GQuinteroP/MASN/docs/img/SENSOR_FRONT.pdf

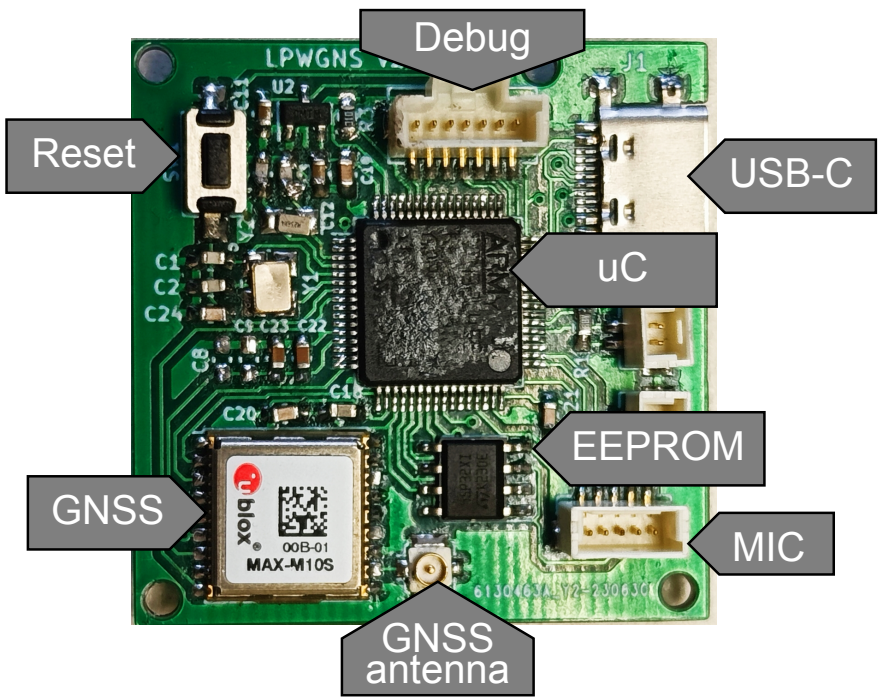
[picture p1: figure]
Debug; EEPROM; USB-C; GNSS; Reset; MIC; GNSS antenna
