GQuinteroP/MASN/docs/img/PCB_FRONT.pdf

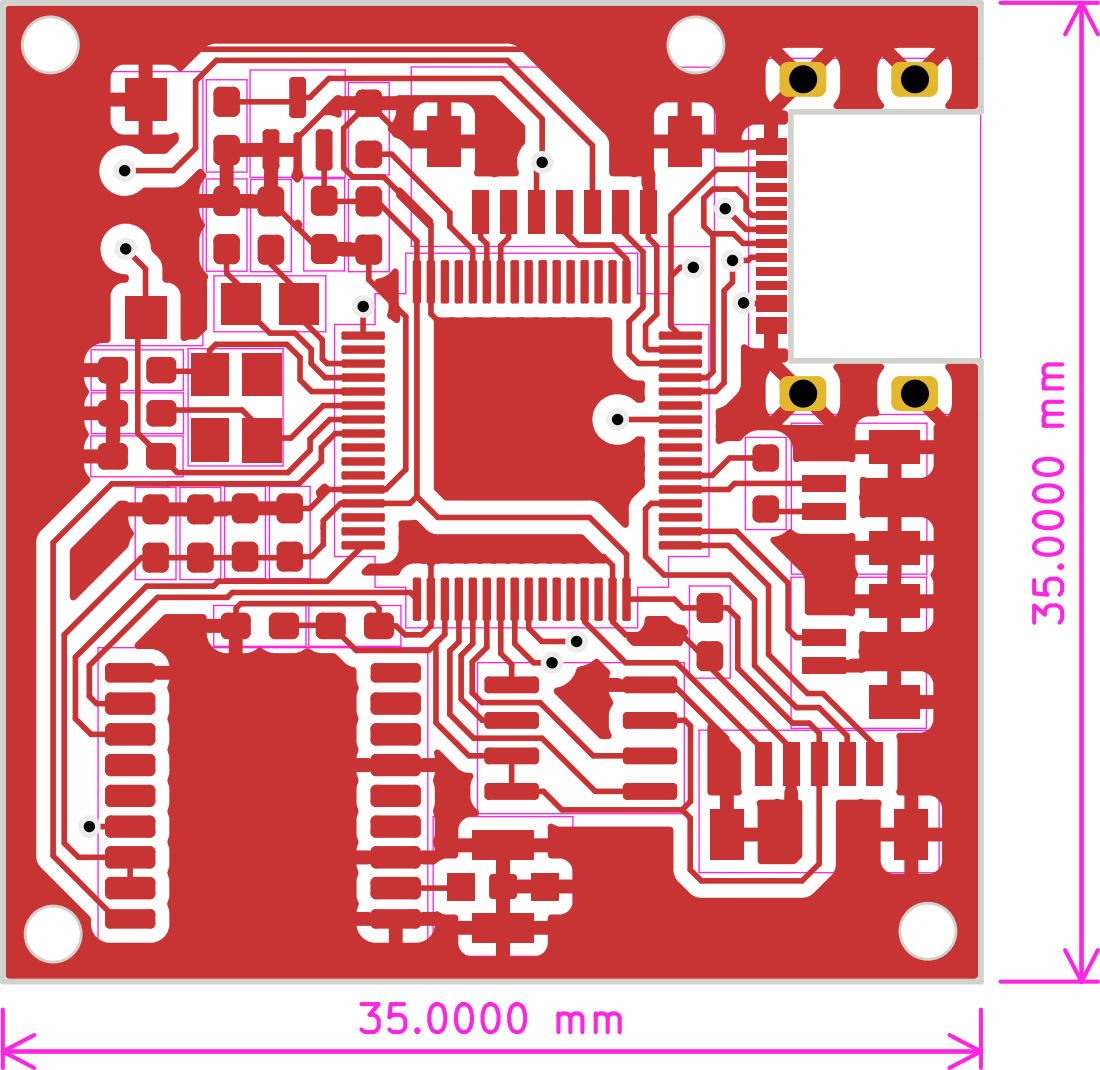
[picture p2: page 1]
