GQuinteroP/MASN/docs/img/PCB_REAR.pdf

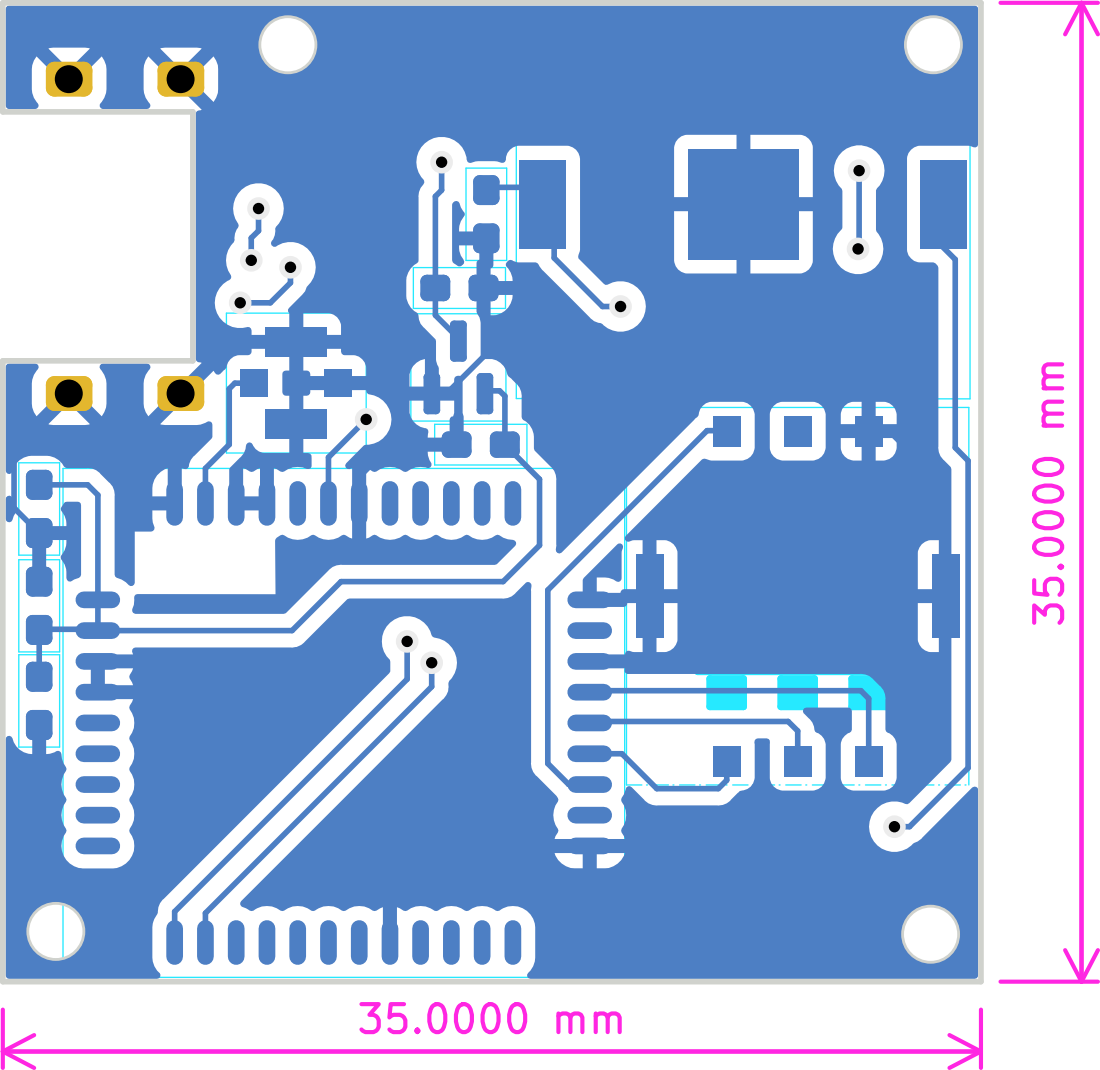
[picture p3: page 1]
