GQuinteroP/MASN/docs/img/SENSOR_BACK.pdf

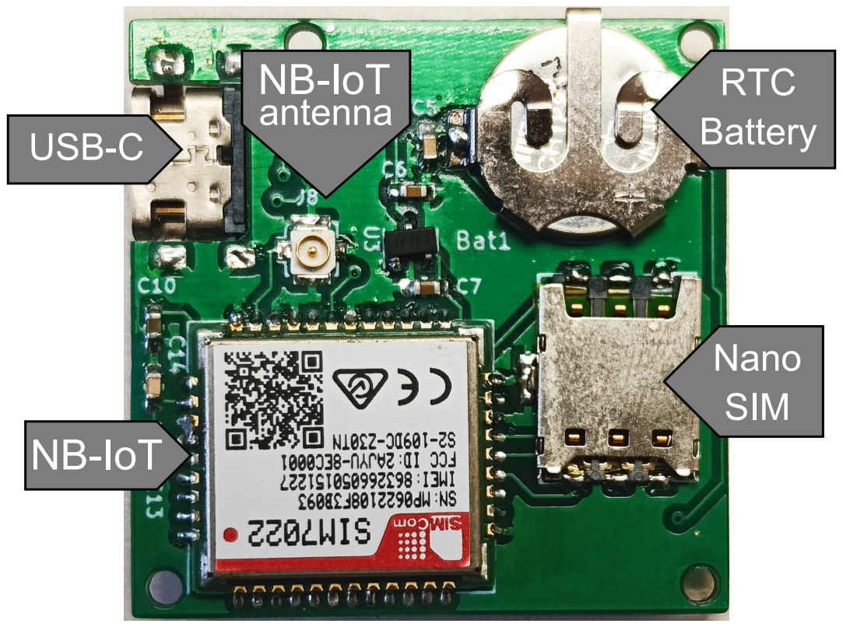
[picture p4: page 1]
NB-IoT
