GQuinteroP/MASN/PCB/MASN.kicad_pcb

## KiCad design PCB/MASN.kicad_pcb (2026-05-15)

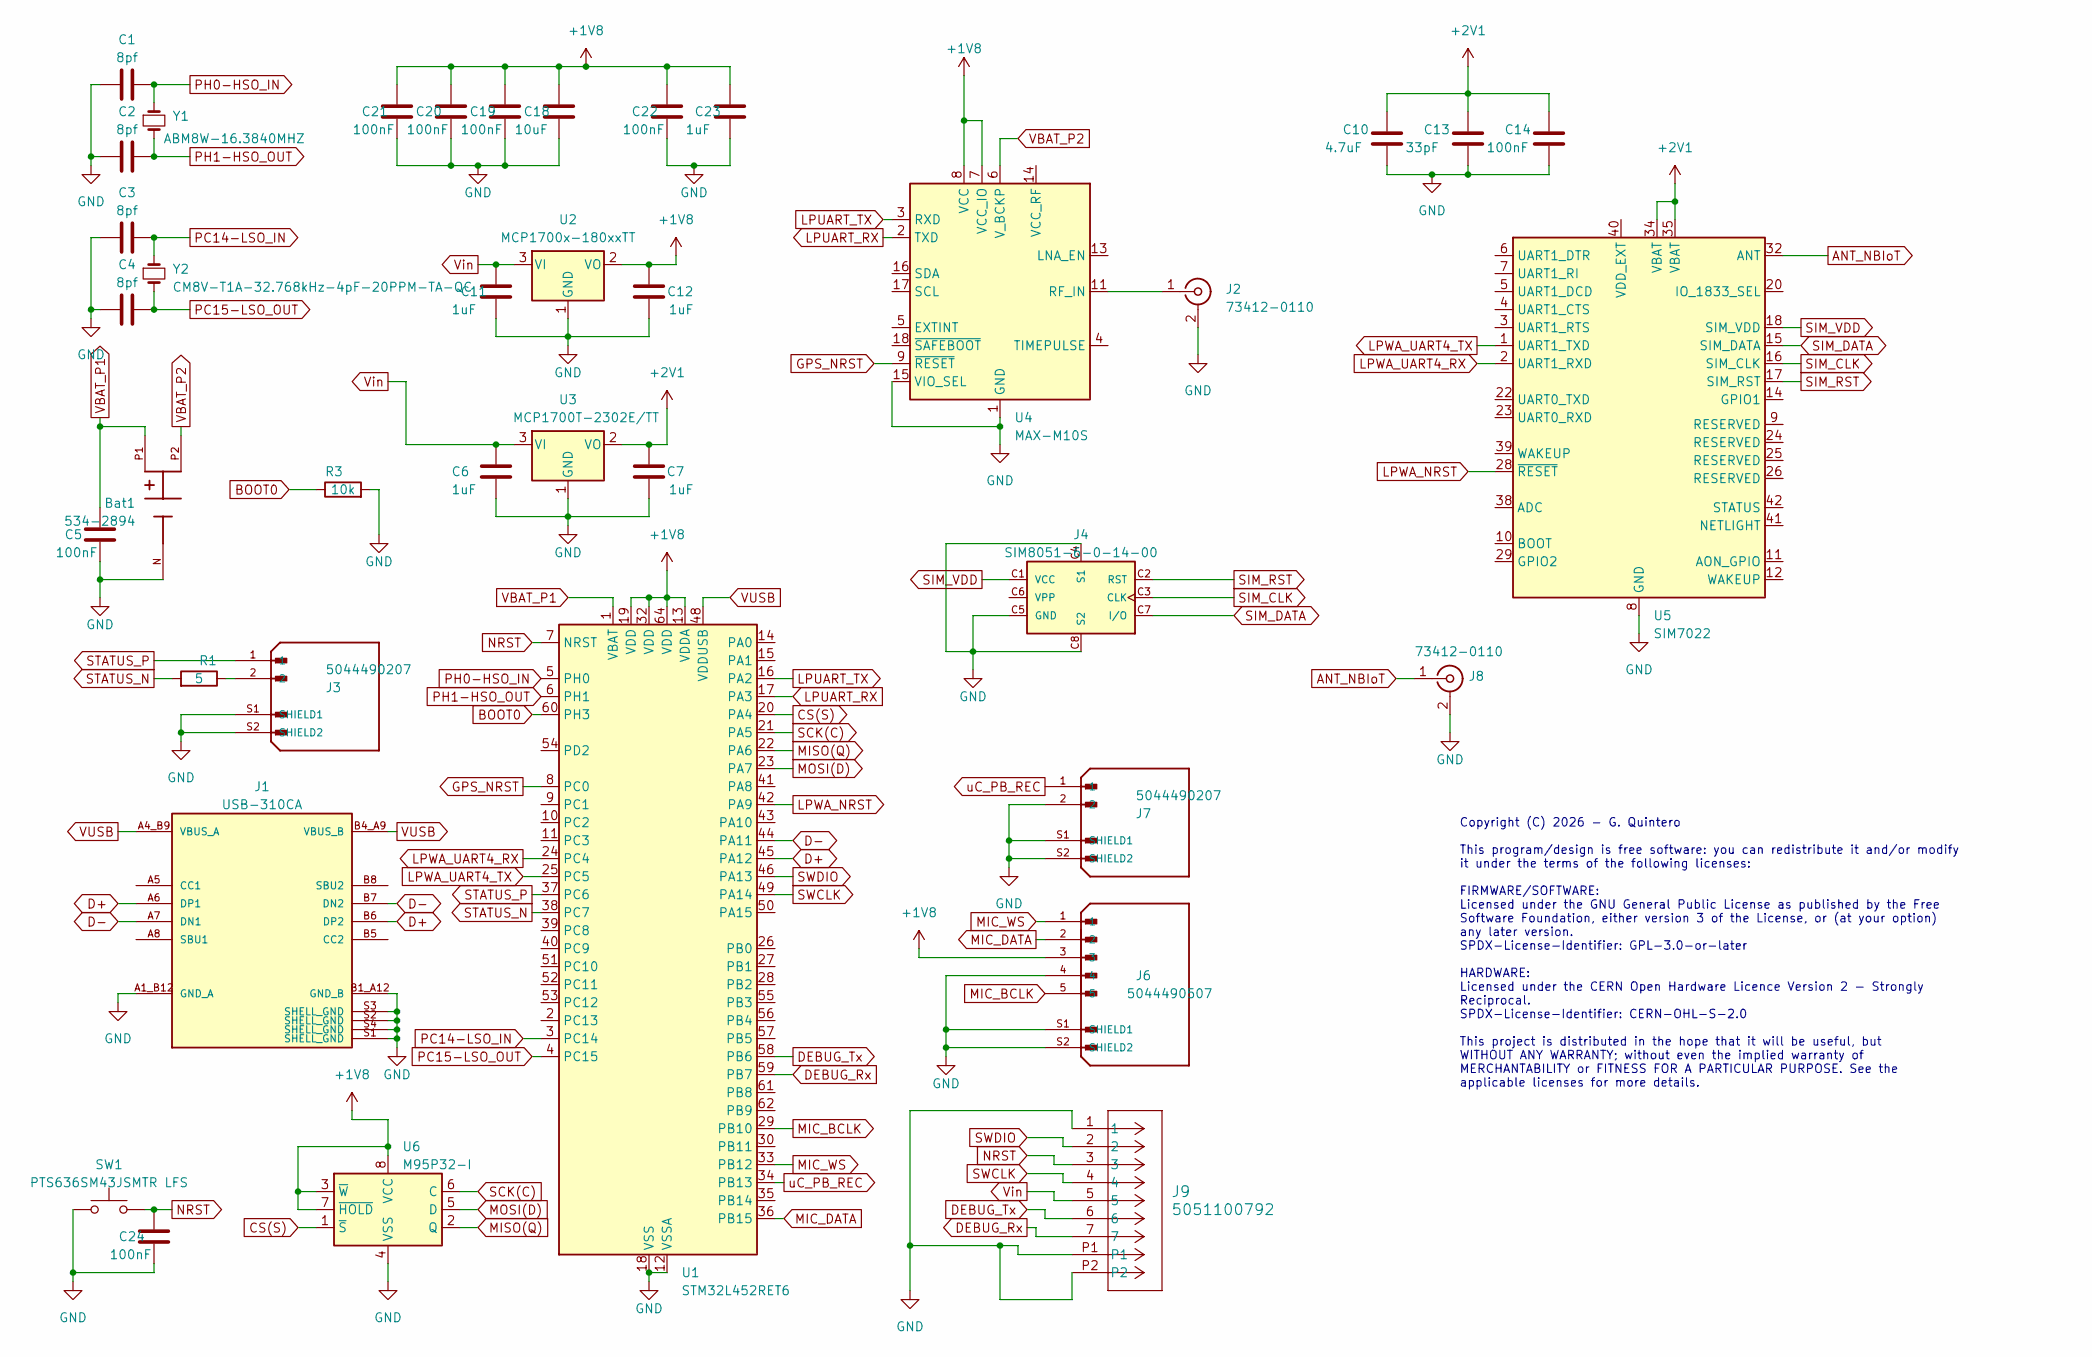
[picture p5: schematic MASN.kicad_sch]

Parts:
Bat1: 534-2894; BAT_2894; PARTREV B
C1, C2, C3, C4: 8pf; C_0603_1608Metric_Pad1.08x0.95mm_HandSolder
C5, C14, C19, C20, C21, C22, C24: 100nF; C_0603_1608Metric_Pad1.08x0.95mm_HandSolder
C6, C7, C11, C12, C23: 1uF; C_0603_1608Metric_Pad1.08x0.95mm_HandSolder
C10: 4.7uF; C_0603_1608Metric_Pad1.08x0.95mm_HandSolder
C13: 33pF; C_0603_1608Metric_Pad1.08x0.95mm_HandSolder
C18: 10uF; C_0603_1608Metric_Pad1.08x0.95mm_HandSolder
J1: USB-310CA; USB-C-SMD_20P-P0.50-L6.5-W11.2; PARTREV A
J2, J8: 73412-0110; U.FL_Molex_MCRF_73412-0110_Vertical
J3, J7: 5044490207; MOLEX_5044490207; PARTREV A
J4: SIM8051-6-0-14-00; GCT_SIM8051-6-0-14-00-X-REVD
J6: 5044490507; MOLEX_5044490507; PARTREV A
J9: 5051100792; CON_5051100792_MOL
R1: 5; R_0603_1608Metric_Pad0.98x0.95mm_HandSolder
R3: 10k; R_0603_1608Metric_Pad0.98x0.95mm_HandSolder
SW1: PTS636SM43JSMTR LFS; SW_SPST_CK_RS282G05A3
U1: STM32L452RET6; LQFP-64_10x10mm_P0.5mm
U2: MCP1700x-180xxTT; SOT-23
U3: MCP1700T-2302E/TT; SOT-23
U4: MAX-M10S; ublox_MAX
U5: SIM7022; SIMCom_SIM800C
U6: M95P32-I; SOIC-8_3.9x4.9mm_P1.27mm
Y1: ABM8W-16.3840MHZ; Crystal_SMD_Abracon_ABM8G-4Pin_Custom
Y2: CM8V-T1A-32.768kHz-4pF-20PPM-TA-QC; Crystal_SMD_MicroCrystal_CC8V-T1A-2Pin_2.0x1.2mm_HandSolder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

Connections:
+1V8: C12.2, C18.2, C19.2, C20.2, C21.2, C22.2, C23.2, J6.3, U1.13 (VDDA), U1.19 (VDD), U1.32 (VDD), U1.64 (VDD), U2.2 (VO), U4.7 (VCC_IO), U4.8 (VCC), U6.3 (~W), U6.7 (~HOLD), U6.8 (VCC)
+2V1: C7.2, C10.2, C13.2, C14.2, U3.2 (VO), U5.34 (VBAT), U5.35 (VBAT)
ANT_NBIoT: J8.1 (In), U5.32 (ANT)
BOOT0: R3.1, U1.60 (PH3)
CS(S): U1.20 (PA4), U6.1 (~S)
D+: J1.A6 (DP1), J1.B6 (DP2), U1.45 (PA12)
D-: J1.A7 (DN1), J1.B7 (DN2), U1.44 (PA11)
DEBUG_Rx: J9.7, U1.59 (PB7)
DEBUG_Tx: J9.6, U1.58 (PB6)
GND: Bat1.N, C1.2, C2.1, C3.2, C4.1, C5.1, C6.1, C7.1, C10.1, C11.1, C12.1, C13.1, C14.1, C18.1, C19.1, C20.1, C21.1, C22.1, C23.1, C24.1, J1.A1_B12 (GND_A), J1.B1_A12 (GND_B), J1.S1 (SHELL_GND), J1.S2 (SHELL_GND), J1.S3 (SHELL_GND), J1.S4 (SHELL_GND), J2.2 (Ext), J3.S1 (SHIELD1), J3.S2 (SHIELD2), J4.C4 (S1), J4.C5 (GND), J4.C8 (S2), J6.4, J6.S1 (SHIELD1), J6.S2 (SHIELD2), J7.2, J7.S1 (SHIELD1), J7.S2 (SHIELD2), J8.2 (Ext), J9.1, J9.P1, J9.P2, R3.2, SW1.1, U1.12 (VSSA), U1.18 (VSS), U1.31 (VSS), U1.47 (VSS), U1.63 (VSS), U2.1 (GND), U3.1 (GND), U4.1 (GND), U4.10 (GND), U4.12 (GND), U4.15 (VIO_SEL), U5.8 (GND), U5.13 (GND), U5.19 (GND), U5.21 (GND), U5.27 (GND), U5.30 (GND), U5.31 (GND), U5.33 (GND), U5.36 (GND), U5.37 (GND), U6.4 (VSS)
GPS_NRST: U1.8 (PC0), U4.9 (~RESET)
LPUART_RX: U1.17 (PA3), U4.2 (TXD)
LPUART_TX: U1.16 (PA2), U4.3 (RXD)
LPWA_NRST: U1.42 (PA9), U5.28 (~RESET)
LPWA_UART4_RX: U1.24 (PC4), U5.2 (UART1_RXD)
LPWA_UART4_TX: U1.25 (PC5), U5.1 (UART1_TXD)
MIC_BCLK: J6.5, U1.29 (PB10)
MIC_DATA: J6.2, U1.36 (PB15)
MIC_WS: J6.1, U1.33 (PB12)
MISO(Q): U1.22 (PA6), U6.2 (Q)
MOSI(D): U1.23 (PA7), U6.5 (D)
NRST: C24.2, J9.3, SW1.2, U1.7 (NRST)
unnamed: J2.1 (In), U4.11 (RF_IN)
unnamed: J3.2, R1.1
PC14-LSO_IN: C3.1, U1.3 (PC14), Y2.1
PC15-LSO_OUT: C4.2, U1.4 (PC15), Y2.2
PH0-HSO_IN: C1.1, U1.5 (PH0), Y1.1
PH1-HSO_OUT: C2.2, U1.6 (PH1), Y1.3
SCK(C): U1.21 (PA5), U6.6 (C)
SIM_CLK: J4.C3 (CLK), U5.16 (SIM_CLK)
SIM_DATA: J4.C7 (I/O), U5.15 (SIM_DATA)
SIM_RST: J4.C2 (RST), U5.17 (SIM_RST)
SIM_VDD: J4.C1 (VCC), U5.18 (SIM_VDD)
STATUS_N: R1.2, U1.38 (PC7)
STATUS_P: J3.1, U1.37 (PC6)
SWCLK: J9.4, U1.49 (PA14)
SWDIO: J9.2, U1.46 (PA13)
VBAT_P1: Bat1.P1, C5.2, U1.1 (VBAT)
VBAT_P2: Bat1.P2, U4.6 (V_BCKP)
VUSB: J1.A4_B9 (VBUS_A), J1.B4_A9 (VBUS_B), U1.48 (VDDUSB)
Vin: C6.2, C11.2, J9.5, U2.3 (VI), U3.3 (VI)
uC_PB_REC: J7.1, U1.34 (PB13)

Notes on the sheet:
Copyright (C) 2026 - G. Quintero This program/design is free software: you can redistribute it and/or modify it under the terms of the following licenses: FIRMWARE/SOFTWARE: Licensed under the GNU General Public License as published by the Free Software Foundation, either version 3 of the License, 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

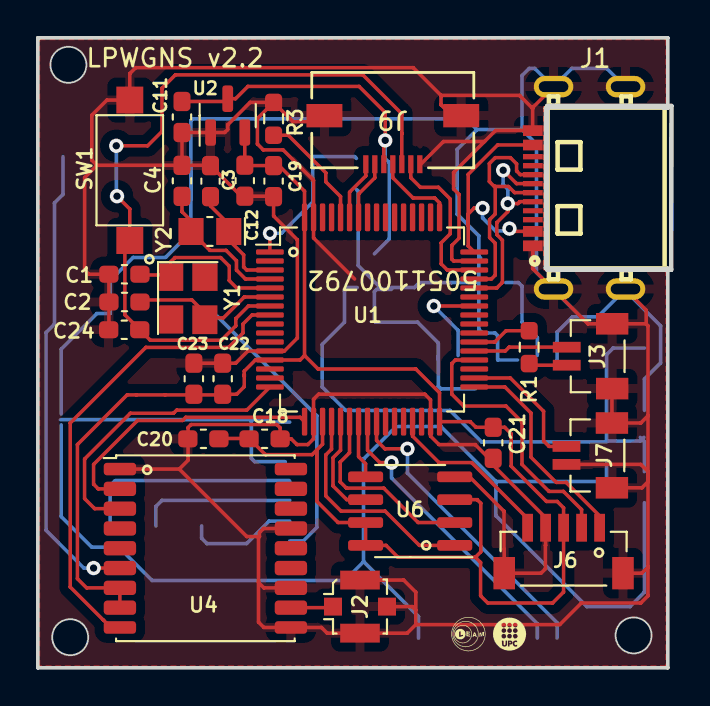
[picture p6: board MASN.kicad_pcb from above]

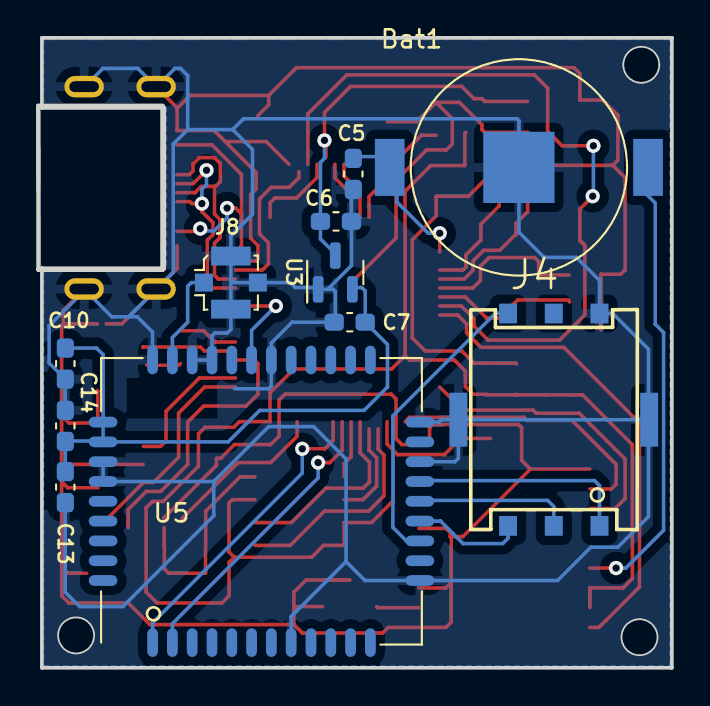
[picture p7: board MASN.kicad_pcb from below]

Board: 2 copper layers, 35.0 x 35.0 mm, 39 parts (11 on the bottom side), 42 nets.
