GQuinteroP/MASN/Firmware/Core/Inc/main.h

#define GPS_NRST_Pin GPIO_PIN_0
#define GPS_NRST_GPIO_Port GPIOC
#define LPUART_GPS_Tx_Pin GPIO_PIN_2
#define LPUART_GPS_Tx_GPIO_Port GPIOA
#define LPUART_GPS_Rx_Pin GPIO_PIN_3
#define LPUART_GPS_Rx_GPIO_Port GPIOA
#define SPI1_CS_Pin GPIO_PIN_4
#define SPI1_CS_GPIO_Port GPIOA
#define PB_REC_Pin GPIO_PIN_13
#define PB_REC_GPIO_Port GPIOB
#define PB_REC_EXTI_IRQn EXTI15_10_IRQn
#define STATUS_P_Pin GPIO_PIN_6
#define STATUS_P_GPIO_Port GPIOC
#define STATUS_N_Pin GPIO_PIN_7
#define STATUS_N_GPIO_Port GPIOC
#define LPWA_NRST_Pin GPIO_PIN_9
#define LPWA_NRST_GPIO_Port GPIOA
#define TMS_Pin GPIO_PIN_13
#define TMS_GPIO_Port GPIOA
#define TCK_Pin GPIO_PIN_14
#define TCK_GPIO_Port GPIOA
#define UART_DEBUG_Tx_Pin GPIO_PIN_6
#define UART_DEBUG_Tx_GPIO_Port GPIOB
#define UART_DEBUG_Rx_Pin GPIO_PIN_7
#define UART_DEBUG_Rx_GPIO_Port GPIOB
