GQuinteroP/MASN/Firmware/Core/Inc/PondFilter.h

//ACoeff
const float32_t ACoeff [2048] = {
0.00000000000, 0.00000001475, 0.00000195875, 0.00002304678, 0.00010731012, 0.00031584672, 0.00071398850, 0.00136343058, 0.00231775634, 0.00362020150,
0.00530308499, 0.00738840195, 0.00988909951, 0.01281064222, 0.01615259286, 0.01991004705, 0.02407484715, 0.02863655864, 0.03358322510, 0.03890193350,
0.04457922535, 0.05060138787, 0.05695465449, 0.06362533877, 0.07059992036, 0.07786509750, 0.08540781658, 0.09321528646, 0.10127498307, 0.10957464816,
0.11810228487, 0.12684615174, 0.13579475650, 0.14493685012, 0.15426142168, 0.16375769416, 0.17341512122, 0.18322338489, 0.19317239421, 0.20325228452,
0.21345341740, 0.22376638111, 0.23418199135, 0.24469129225, 0.25528555751, 0.26595629156, 0.27669523064, 0.28749434384, 0.29834583384, 0.30924213756,
0.32017592640, 0.33114010632, 0.34212781756, 0.35313243397, 0.36414756212, 0.37516703998, 0.38618493536, 0.39719554391, 0.40819338694, 0.41917320881,
0.43012997411, 0.44105886458, 0.45195527568, 0.46281481306, 0.47363328870, 0.48440671690, 0.49513131012, 0.50580347462, 0.51641980595, 0.52697708441,
0.53747227027, 0.54790249906, 0.55826507667, 0.56855747448, 0.57877732439, 0.58892241393, 0.59899068123, 0.60898021011, 0.61888922517, 0.62871608682,
0.63845928649, 0.64811744180, 0.65768929178, 0.66717369222, 0.67656961104, 0.68587612376, 0.69509240906, 0.70421774443, 0.71325150188, 0.72219314379,
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
1.32809186911, 1.32772263746, 1.32734855340, 1.32696965390, 1.32658597554, 1.32619755456, 1.32580442682, 1.32540662787, 1.32500419288, 1.32459715668,
1.32418555379, 1.32376941838, 1.32334878429, 1.32292368505, 1.32249415385, 1.32206022359, 1.32162192685, 1.32117929589, 1.32073236268, 1.32028115890,
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
