GQuinteroP/MASN/Firmware/Core/Inc/EEPROM.h

/*
 * EEPROM.h
 *
 *  Created on: Jul 4, 2023
 *      Author: ubuntu
 */

#ifndef INC_EEPROM_H_
#define INC_EEPROM_H_

#include "stdint.h"

uint16_t get_eeprom_data_len();
uint16_t get_eeprom_read_idx();

#endif /* INC_EEPROM_H_ */
