GQuinteroP/MASN/(commit log)

2026-02-05 Hardware commit (PCB)
    [MASN.csv, MASN.kicad_pcb, MASN.kicad_sch, MASN.xlsx]
2026-02-05 Licenses update
    [MASN.kicad_pcb, MASN.kicad_sch]
2026-05-15 Delta-coding, automatic IMEI and timestamp working (1 s samples)
    [MASN.kicad_pcb, MASN.kicad_sch]
2026-05-15 Some bugs solved. 125 ms minimal working
    [SIMCOM7022.c, SIMCOM7022.h, main.c, main.h]
2026-05-22 Some bugs solved. Working offline for different Leq integration times
    [SIMCOM7022.c, main.c, main.h]
2026-05-30 Long term GNSS crash when offline solved. Changed to circular DMA for GNSS
    [MASN.ioc, SIMCOM7022.c, SIMCOM7022.h, main.c, main.h]
2026-06-11 GNSS lost signal crash when PSM activated solved
    [MASN.ioc, SIMCOM7022.c, m95p32.c, main.c, main.h]
