GQuinteroP/MASN/(notices)

Notices in the files:
Firmware/Core/Src/main.c:
Copyright (c) 2023 STMicroelectronics.
All rights reserved.
PCB/MASN.kicad_sch:
SPDX-License-Identifier: GPL-3.0-or-later
HARDWARE:
Licensed under the CERN Open Hardware Licence Version 2 - Strongly
SPDX-License-Identifier: CERN-OHL-S-2.0
